jancoow/seat-canbus/pcb/car.sch

## KiCad design pcb/car.sch (2019-08-25)

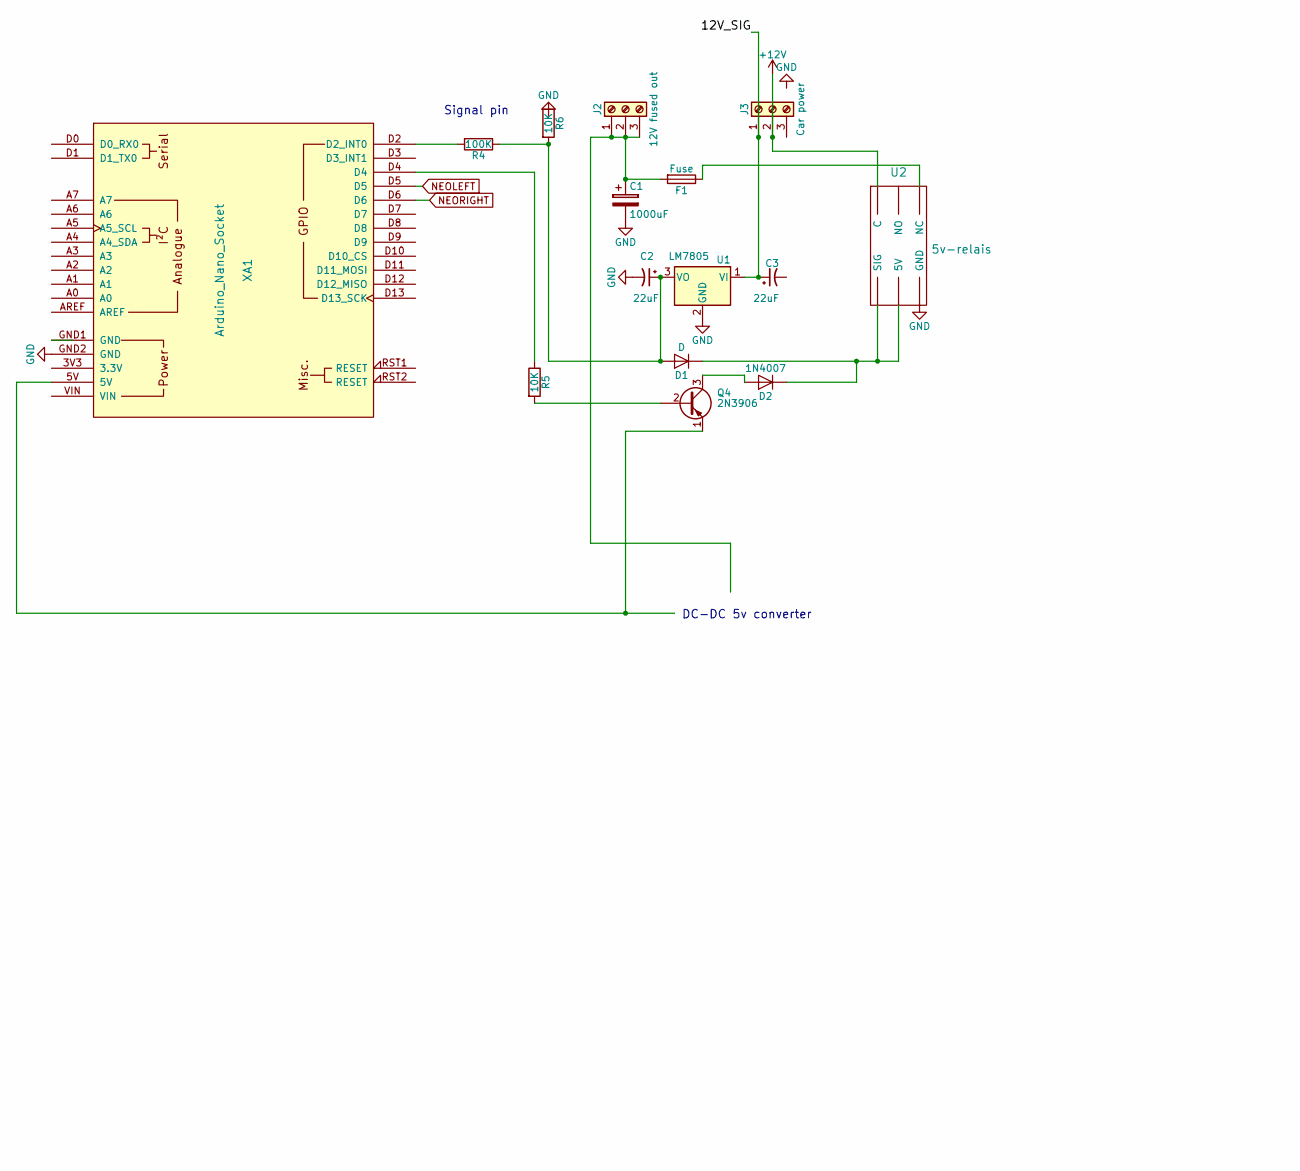
[picture p5: schematic car.sch, part in row 1, column 1]

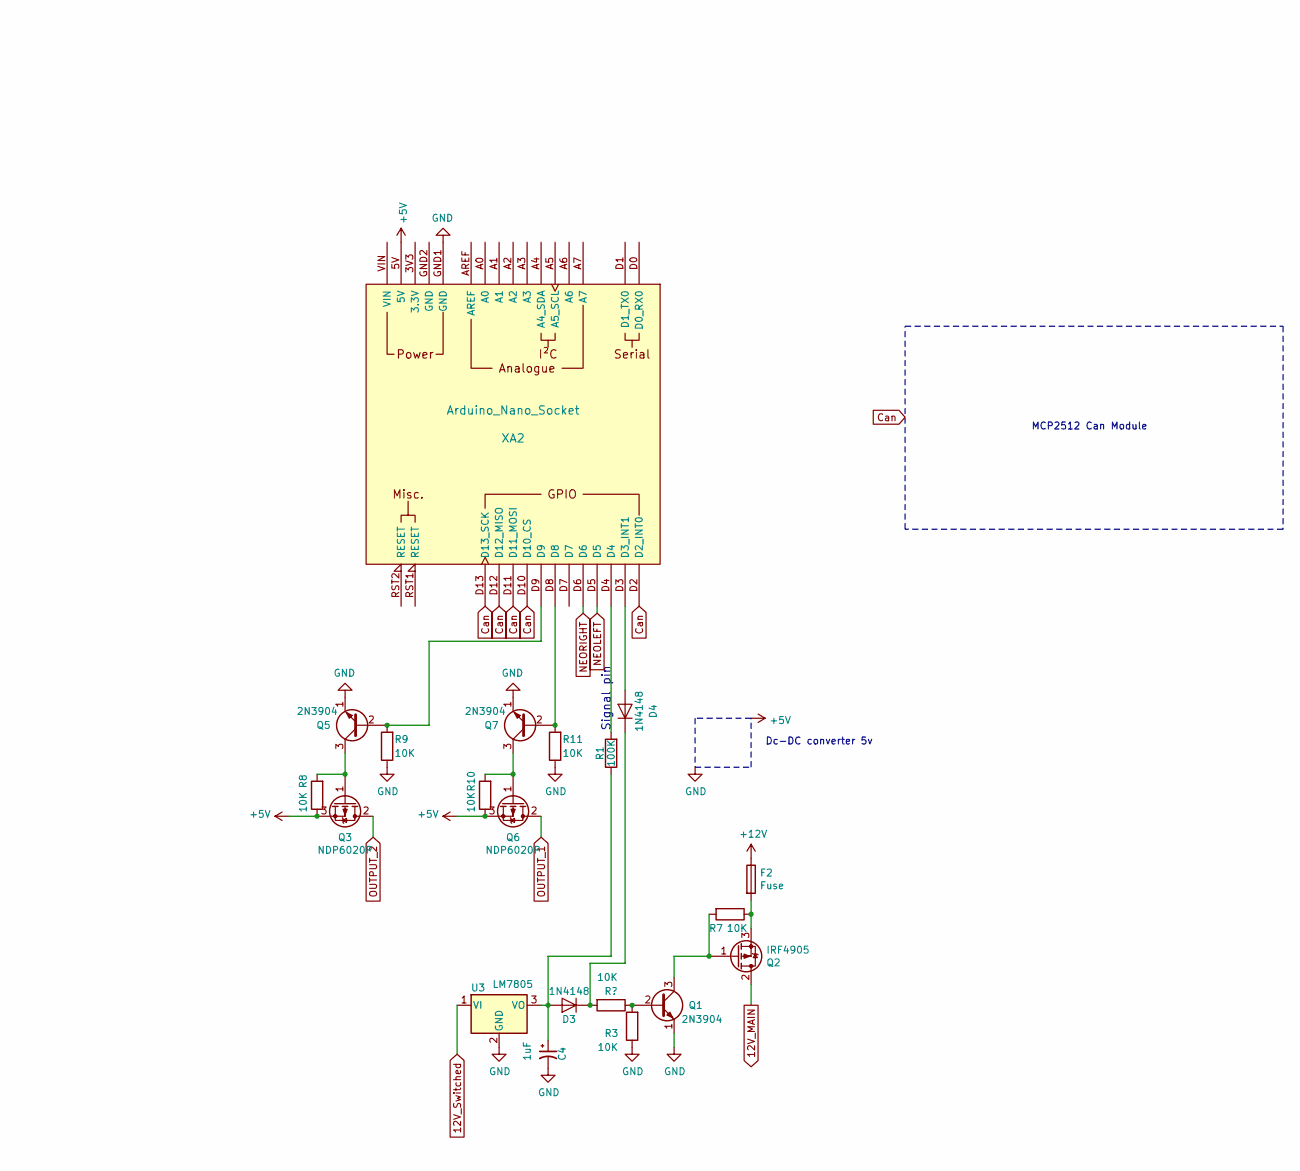
[picture p6: schematic car.sch, part in row 1, column 2]

Parts:
C1: 1000uF
C2, C3: 22uF
C4: 1uF
D1: D
D2: 1N4007
D3, D4: 1N4148
F1, F2: Fuse
J2: 12V fused out
J3: Car power
Q1, Q5, Q7: 2N3904; TO-92_Inline
Q2: IRF4905; TO-220-3_Vertical
Q3, Q6: NDP6020P; TO-220-3_Vertical
Q4: 2N3906; TO-92_Molded_Narrow
R1, R4: 100K
R3, R5, R6, R7, R8, R9, R10, R11: 10K
U1, U3: LM7805; TO-220_Vertical
U2: 5v-relais
XA1, XA2: Arduino_Nano_Socket

Connections:
12V_MAIN: Q2.2 (D)
12V_SIG: C3.1, J3.1, U1.1 (VI)
12V_Switched: U3.1 (VI)
+5V: Q3.3 (S), Q6.3 (S), R8.1, R10.1, XA2.5V
+12V: F2.1, J3.2, U2.~
Can: XA2.D2 (D2_INT0), XA2.D10 (D10_CS), XA2.D11 (D11_MOSI), XA2.D12 (D12_MISO), XA2.D13 (D13_SCK)
GND: C1.2, C2.2, C4.2, Q1.1 (E), Q5.1 (E), Q7.1 (E), R3.1, R9.1, R11.1, U1.2 (GND), U2.~, U3.2 (GND), XA1.GND2 (GND), XA2.GND1 (GND)
NEOLEFT: XA1.D5, XA2.D5
NEORIGHT: XA1.D6, XA2.D6
unnamed: C1.1, F1.2, J2.1, J2.2, J2.3
unnamed: C2.1, D1.2 (A), R4.1, R6.2, U1.3 (VO)
unnamed: C4.1, D3.2 (A), R1.1, U3.3 (VO)
unnamed: D1.1 (K), D2.1 (K), U2.~
unnamed: D2.2 (A), Q4.3 (C)
unnamed: D3.1 (K), D4.1 (K)
unnamed: D4.2 (A), XA2.D3 (D3_INT1)
unnamed: F1.1, U2.~
unnamed: F2.2, Q2.3 (S), R7.1
unnamed: Q1.2 (B), R3.2
unnamed: Q1.3 (C), Q2.1 (G), R7.2
unnamed: Q3.1 (G), Q5.3 (C), R8.2
unnamed: Q4.1 (E), XA1.5V
unnamed: Q4.2 (B), R5.2
unnamed: Q5.2 (B), R9.2, XA2.D9
unnamed: Q6.1 (G), Q7.3 (C), R10.2
unnamed: Q7.2 (B), R11.2, XA2.D8
unnamed: R1.2, XA2.D4
unnamed: R4.2, XA1.D2 (D2_INT0)
unnamed: R5.1, XA1.D4
OUTPUT_1: Q6.2 (D)
OUTPUT_2: Q3.2 (D)

Notes on the sheet:
DC-DC 5v converter
Signal pin
Dc-DC converter 5v
MCP2512 Can Module
