jancoow/seat-canbus/(commit log)

2019-04-07 First schematic draft
    [car.sch]
2019-08-25 Draft schematic: Arduino Nano, MCP2515 CAN module and 12V power latch
    [car.sch]
2020-07-11 Group CAN handlers in carcanbus/ and LED code in carled/
2021-10-17 PlatformIO project with LED controller and colour mode
2022-04-25 Rainbow mode, turn signal sweep, brake lights and light-based dimming
